Erhannis/VoltageBoard/voltage_tests.kicad_pcb

## KiCad design voltage_tests.kicad_pcb (2023-08-18)

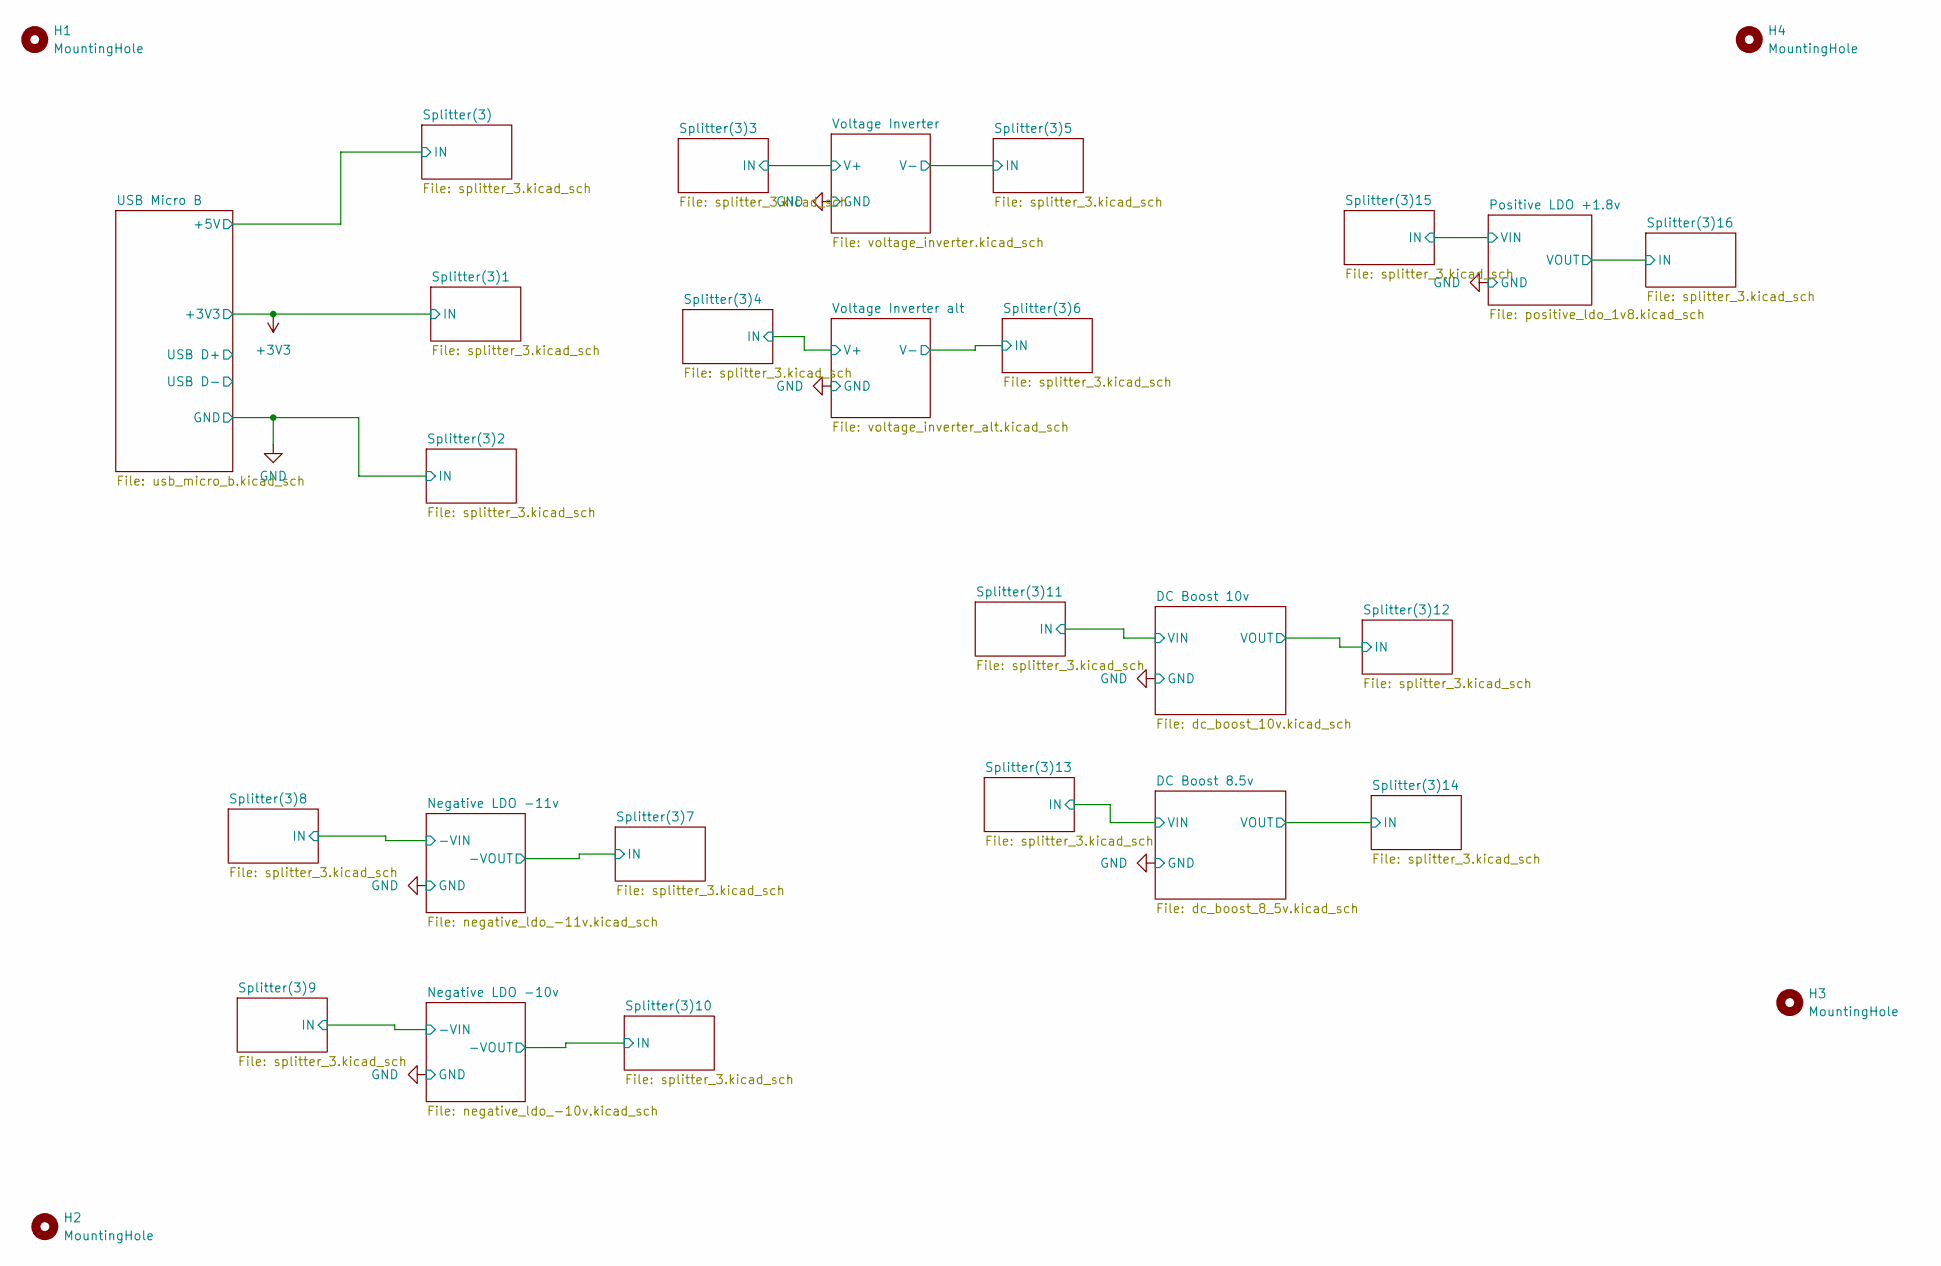
[picture p1: schematic voltage_tests.kicad_sch]

Parts:
H1, H2, H3, H4: MountingHole; MountingHole_2.5mm

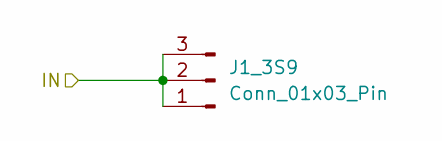
[picture p2: schematic splitter_3.kicad_sch]

Parts:
J1_3S9: Conn_01x03_Pin; PinHeader_1x03_P2.54mm_Vertical; LCSC C2937625

Connections:
/Negative LDO -11v/-VIN: J1_3S9.1, J1_3S9.2, J1_3S9.3; also elsewhere on the board

Parts of its further copies:
J1_3S1, J1_3S2, J1_3S3, J1_3S4, J1_3S5, J1_3S6, J1_3S7, J1_3S8, J1_3S10, J1_3S11, J1_3S12, J1_3S13, J1_3S14, J1_3S15, J1_3S16, J1_3S17: Conn_01x03_Pin; PinHeader_1x03_P2.54mm_Vertical; LCSC C2937625

Connections of its further copies:
+3V3: J1_3S2.1, J1_3S2.2, J1_3S2.3; also elsewhere on the board
/DC Boost 8.5v/VIN: J1_3S15.1, J1_3S15.2, J1_3S15.3; also elsewhere on the board
/DC Boost 8.5v/VOUT: J1_3S14.1, J1_3S14.2, J1_3S14.3; also elsewhere on the board
/DC Boost 10v/VIN: J1_3S13.1, J1_3S13.2, J1_3S13.3; also elsewhere on the board
/DC Boost 10v/VOUT: J1_3S12.1, J1_3S12.2, J1_3S12.3; also elsewhere on the board
/Negative LDO -10v/-VIN: J1_3S11.1, J1_3S11.2, J1_3S11.3; also elsewhere on the board
/Negative LDO -10v/-VOUT: J1_3S10.1, J1_3S10.2, J1_3S10.3; also elsewhere on the board
/Negative LDO -11v/-VOUT: J1_3S8.1, J1_3S8.2, J1_3S8.3; also elsewhere on the board
/Positive LDO +1.8v/VIN: J1_3S16.1, J1_3S16.2, J1_3S16.3; also elsewhere on the board
/Positive LDO +1.8v/VOUT: J1_3S17.1, J1_3S17.2, J1_3S17.3; also elsewhere on the board
/Splitter(3)3/IN: J1_3S4.1, J1_3S4.2, J1_3S4.3; also elsewhere on the board
/Splitter(3)4/IN: J1_3S5.1, J1_3S5.2, J1_3S5.3; also elsewhere on the board
/Splitter(3)5/IN: J1_3S6.1, J1_3S6.2, J1_3S6.3; also elsewhere on the board
/Splitter(3)6/IN: J1_3S7.1, J1_3S7.2, J1_3S7.3; also elsewhere on the board
/Splitter(3)/IN: J1_3S1.1, J1_3S1.2, J1_3S1.3; also elsewhere on the board
GND: J1_3S3.1, J1_3S3.2, J1_3S3.3; also elsewhere on the board

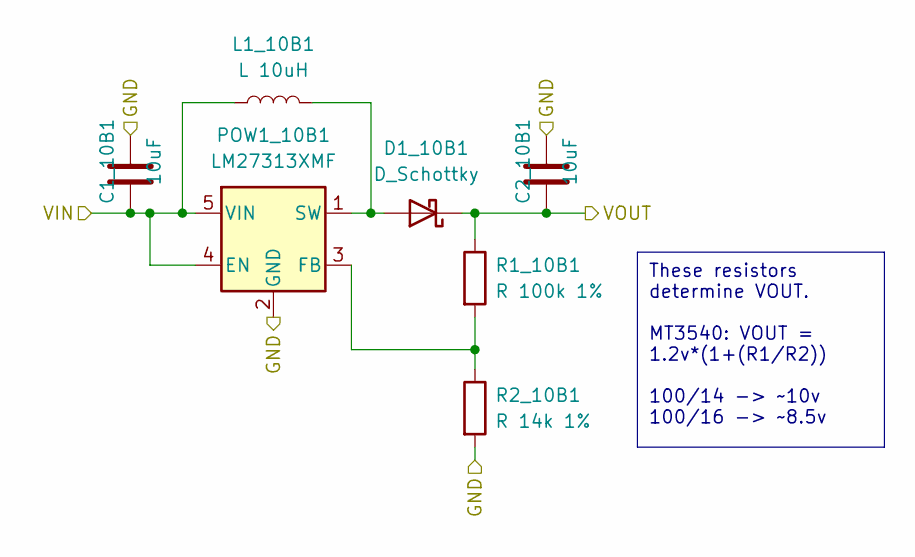
[picture p3: schematic dc_boost_10v.kicad_sch, DC/DC Boost Converter: 10V]

Parts:
C1_10B1, C2_10B1: 10uF; C_0603_1608Metric; LCSC C194427
D1_10B1: D_Schottky; D_0402_1005Metric; LCSC C2837790
L1_10B1: L 10uH; L_0805_2012Metric; LCSC C285963
POW1_10B1: LM27313XMF; SOT-23-5; LCSC C181744
R1_10B1: R 100k 1%; R_0402_1005Metric; LCSC C60491
R2_10B1: R 14k 1%; R_0402_1005Metric; LCSC C3015834

Connections:
/DC Boost 10v/VIN: C1_10B1.2, L1_10B1.1, POW1_10B1.4 (EN), POW1_10B1.5 (VIN); also elsewhere on the board
/DC Boost 10v/VOUT: C2_10B1.2, D1_10B1.1 (K), R1_10B1.1; also elsewhere on the board
GND: C1_10B1.1, C2_10B1.1, POW1_10B1.2 (GND), R2_10B1.2; also elsewhere on the board
unnamed: D1_10B1.2 (A), L1_10B1.2, POW1_10B1.1 (SW)
unnamed: POW1_10B1.3 (FB), R1_10B1.2, R2_10B1.1

Notes on the sheet:
These resistors determine VOUT. MT3540: VOUT = 1.2v*(1+(R1/R2)) 100/14 -> ~10v 100/16 -> ~8.5v

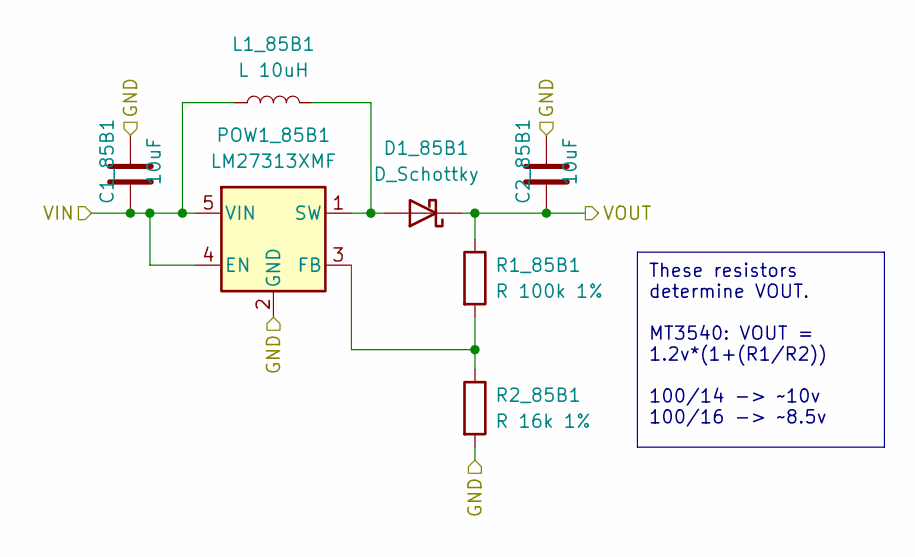
[picture p4: schematic dc_boost_8_5v.kicad_sch, DC/DC Boost Converter: 8.5V]

Parts:
C1_85B1, C2_85B1: 10uF; C_0603_1608Metric; LCSC C194427
D1_85B1: D_Schottky; D_0402_1005Metric; LCSC C2837790
L1_85B1: L 10uH; L_0805_2012Metric; LCSC C285963
POW1_85B1: LM27313XMF; SOT-23-5; LCSC C181744
R1_85B1: R 100k 1%; R_0402_1005Metric; LCSC C60491
R2_85B1: R 16k 1%; R_0402_1005Metric; LCSC C163487

Connections:
/DC Boost 8.5v/VIN: C1_85B1.2, L1_85B1.1, POW1_85B1.4 (EN), POW1_85B1.5 (VIN); also elsewhere on the board
/DC Boost 8.5v/VOUT: C2_85B1.2, D1_85B1.1 (K), R1_85B1.1; also elsewhere on the board
GND: C1_85B1.1, C2_85B1.1, POW1_85B1.2 (GND), R2_85B1.2; also elsewhere on the board
unnamed: D1_85B1.2 (A), L1_85B1.2, POW1_85B1.1 (SW)
unnamed: POW1_85B1.3 (FB), R1_85B1.2, R2_85B1.1

Notes on the sheet:
These resistors determine VOUT. MT3540: VOUT = 1.2v*(1+(R1/R2)) 100/14 -> ~10v 100/16 -> ~8.5v

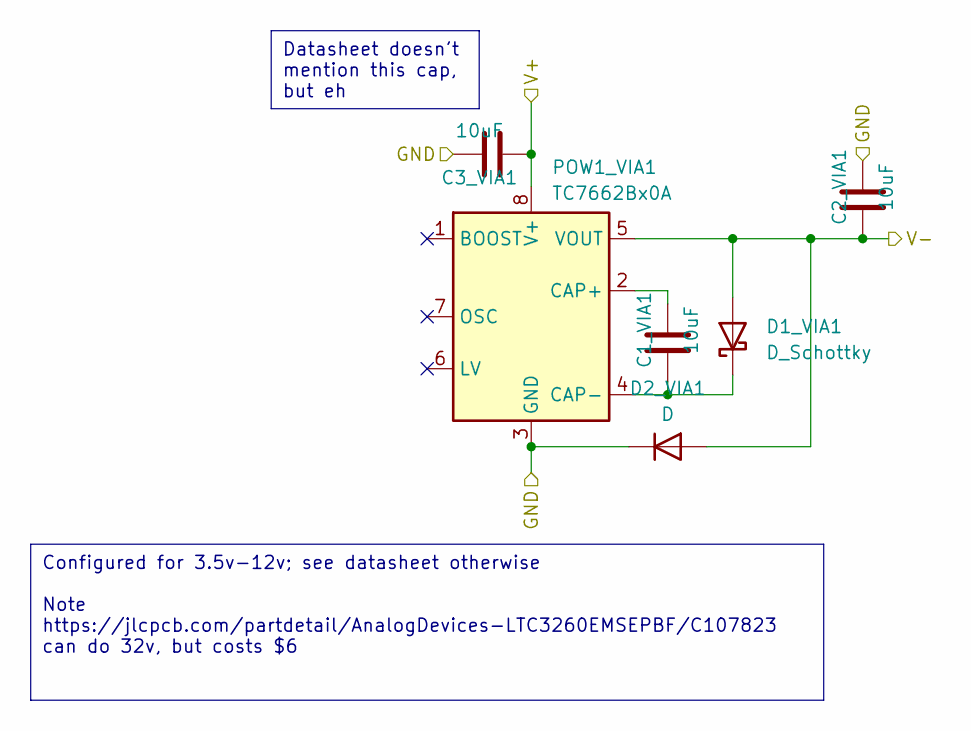
[picture p5: schematic voltage_inverter_alt.kicad_sch, Voltage Inverter 3.5v-12v]

Parts:
C1_VIA1, C2_VIA1, C3_VIA1: 10uF; C_0805_2012Metric; LCSC C1713
D1_VIA1: D_Schottky; D_0402_1005Metric; LCSC C2837790
D2_VIA1: D; D_0805_2012Metric; LCSC C109001
POW1_VIA1: TC7662Bx0A; SOIC-8_3.9x4.9mm_P1.27mm; LCSC C357815

Connections:
/Splitter(3)4/IN: C3_VIA1.2, POW1_VIA1.8 (V+); also elsewhere on the board
/Splitter(3)6/IN: C2_VIA1.2, D1_VIA1.2 (A), D2_VIA1.2 (A), POW1_VIA1.5 (VOUT); also elsewhere on the board
GND: C2_VIA1.1, C3_VIA1.1, D2_VIA1.1 (K), POW1_VIA1.3 (GND); also elsewhere on the board
unnamed: C1_VIA1.2, D1_VIA1.1 (K), POW1_VIA1.4 (CAP-)
unnamed: C1_VIA1.1, POW1_VIA1.2 (CAP+)

Notes on the sheet:
Configured for 3.5v-12v; see datasheet otherwise Note https://jlcpcb.com/partdetail/AnalogDevices-LTC3260EMSEPBF/C107823 can do 32v, but costs $6
Datasheet doesn't mention this cap, but eh

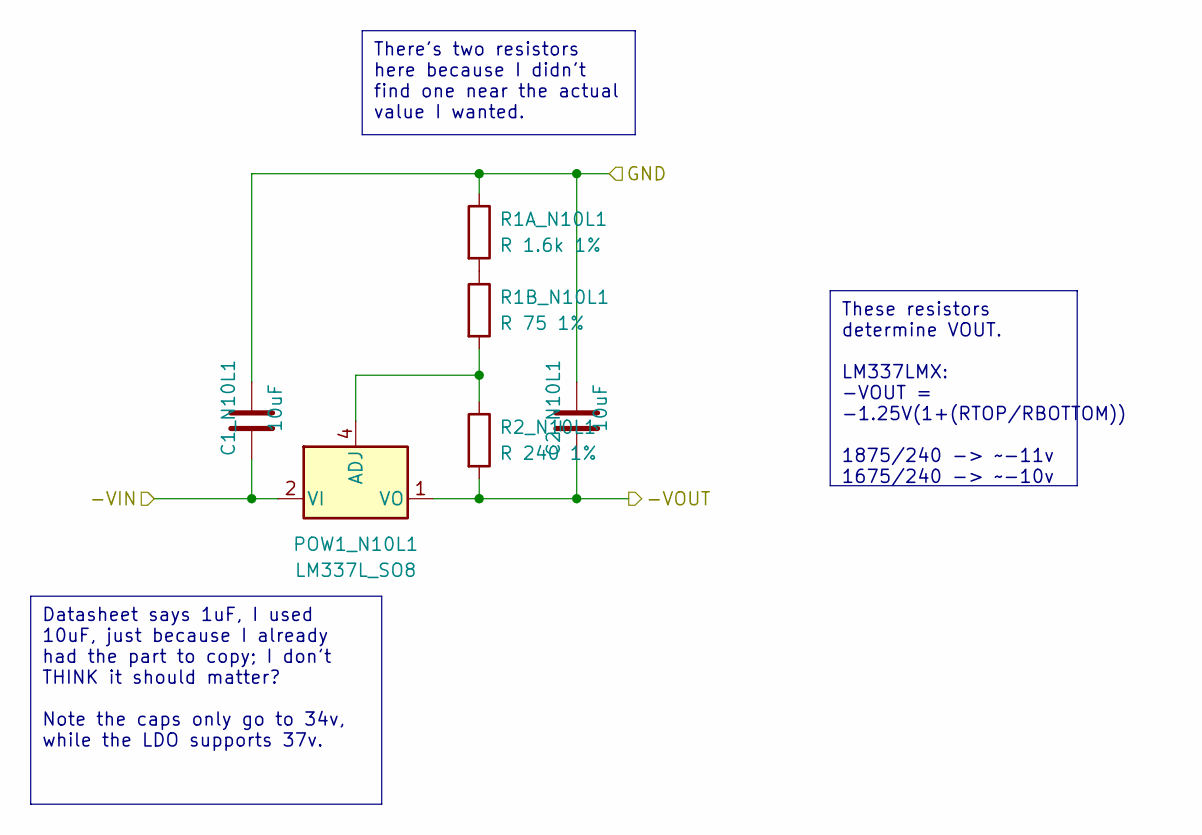
[picture p6: schematic negative_ldo_-10v.kicad_sch, Negative LDO: -10V]

Parts:
C1_N10L1, C2_N10L1: 10uF; C_0603_1608Metric; LCSC C194427
POW1_N10L1: LM337L_SO8; SOIC-8_3.9x4.9mm_P1.27mm; LCSC C544819
R1A_N10L1: R 1.6k 1%; R_0402_1005Metric; LCSC C4908
R1B_N10L1: R 75 1%; R_0402_1005Metric; LCSC C25133
R2_N10L1: R 240 1%; R_0402_1005Metric; LCSC C25094

Connections:
/Negative LDO -10v/-VIN: C1_N10L1.2, POW1_N10L1.2 (VI), POW1_N10L1.3 (VI), POW1_N10L1.6 (VI), POW1_N10L1.7 (VI); also elsewhere on the board
/Negative LDO -10v/-VOUT: C2_N10L1.2, POW1_N10L1.1 (VO), R2_N10L1.2; also elsewhere on the board
GND: C1_N10L1.1, C2_N10L1.1, R1A_N10L1.1; also elsewhere on the board
unnamed: POW1_N10L1.4 (ADJ), R1B_N10L1.2, R2_N10L1.1
unnamed: R1A_N10L1.2, R1B_N10L1.1

Notes on the sheet:
There's two resistors here because I didn't find one near the actual value I wanted.
Datasheet says 1uF, I used 10uF, just because I already had the part to copy; I don't THINK it should matter? Note the caps only go to 34v, while the LDO supports 37v.
These resistors determine VOUT. LM337LMX: -VOUT = -1.25V(1+(RTOP/RBOTTOM)) 1875/240 -> ~-11v 1675/240 -> ~-10v

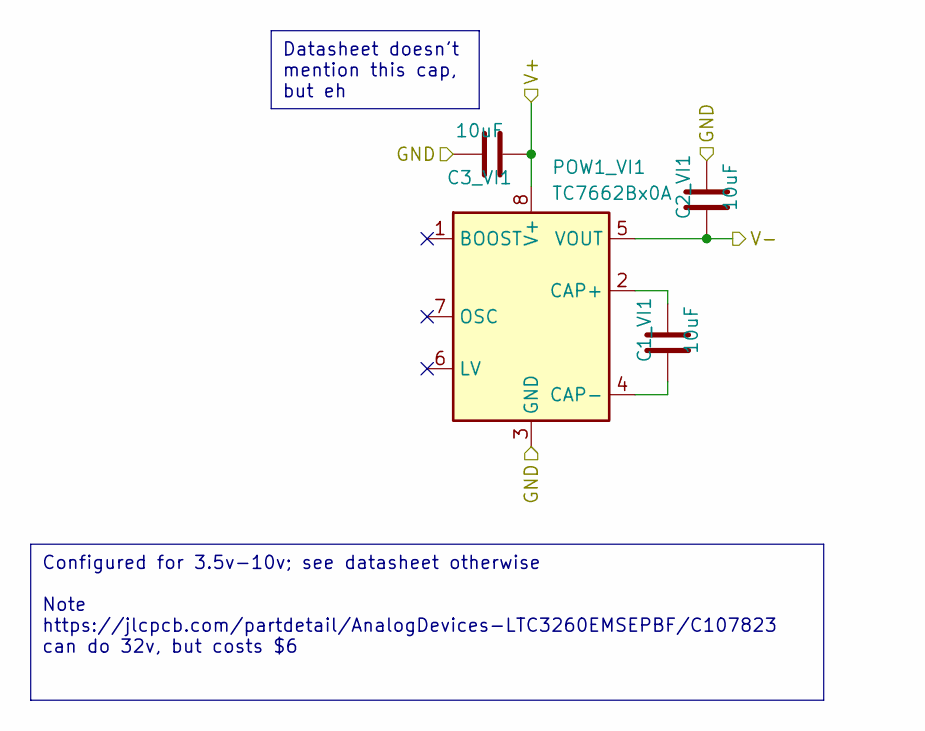
[picture p7: schematic voltage_inverter.kicad_sch, Voltage Inverter 3.5v-10v]

Parts:
C1_VI1, C2_VI1, C3_VI1: 10uF; C_0805_2012Metric; LCSC C1713
POW1_VI1: TC7662Bx0A; SOIC-8_3.9x4.9mm_P1.27mm; LCSC C88402

Connections:
/Splitter(3)3/IN: C3_VI1.2, POW1_VI1.8 (V+); also elsewhere on the board
/Splitter(3)5/IN: C2_VI1.2, POW1_VI1.5 (VOUT); also elsewhere on the board
GND: C2_VI1.1, C3_VI1.1, POW1_VI1.3 (GND); also elsewhere on the board
unnamed: C1_VI1.1, POW1_VI1.2 (CAP+)
unnamed: C1_VI1.2, POW1_VI1.4 (CAP-)

Notes on the sheet:
Configured for 3.5v-10v; see datasheet otherwise Note https://jlcpcb.com/partdetail/AnalogDevices-LTC3260EMSEPBF/C107823 can do 32v, but costs $6
Datasheet doesn't mention this cap, but eh

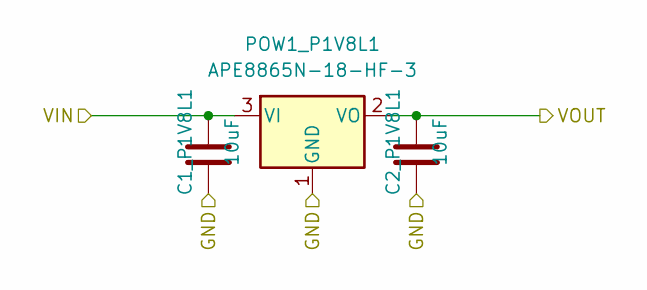
[picture p8: schematic positive_ldo_1v8.kicad_sch]

Parts:
C1_P1V8L1, C2_P1V8L1: 10uF; C_0603_1608Metric; LCSC C194427
POW1_P1V8L1: APE8865N-18-HF-3; SOT-23; LCSC C347373

Connections:
/Positive LDO +1.8v/VIN: C1_P1V8L1.1, POW1_P1V8L1.3 (VI); also elsewhere on the board
/Positive LDO +1.8v/VOUT: C2_P1V8L1.1, POW1_P1V8L1.2 (VO); also elsewhere on the board
GND: C1_P1V8L1.2, C2_P1V8L1.2, POW1_P1V8L1.1 (GND); also elsewhere on the board

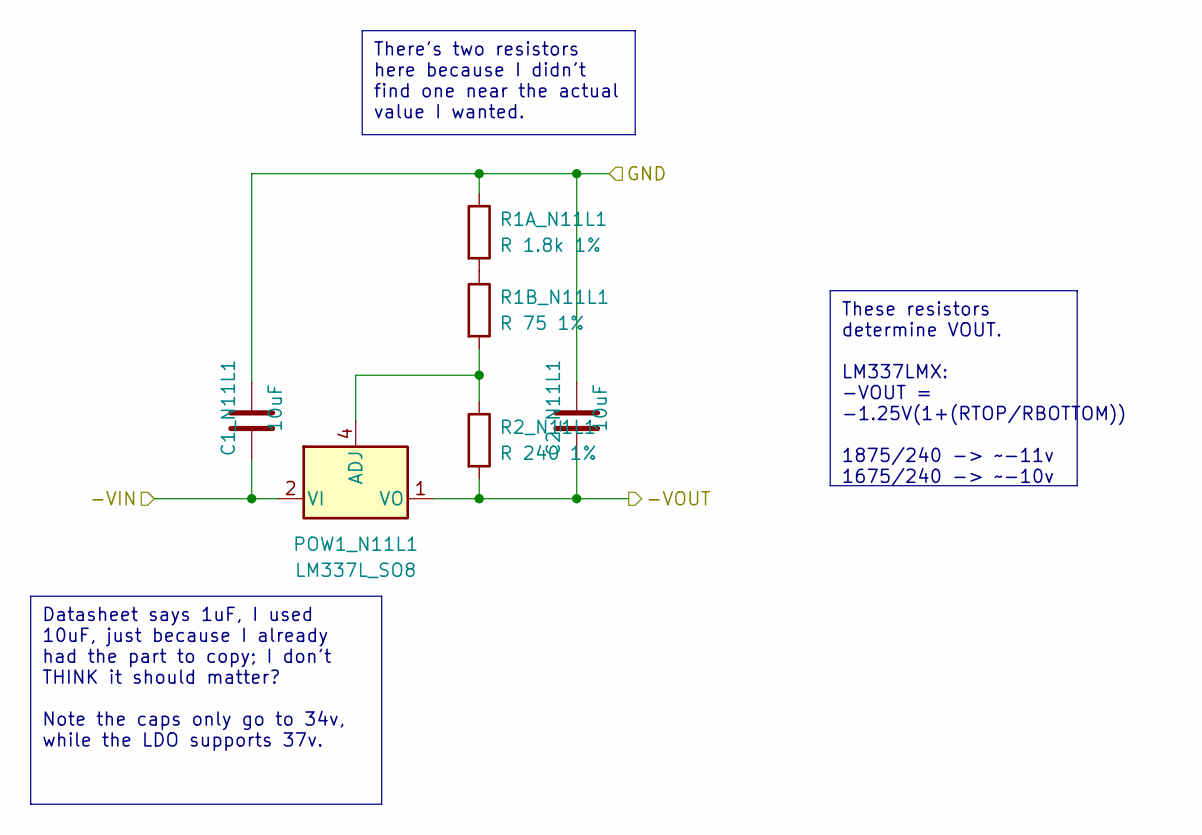
[picture p9: schematic negative_ldo_-11v.kicad_sch, Negative LDO: -11V]

Parts:
C1_N11L1, C2_N11L1: 10uF; C_0603_1608Metric; LCSC C194427
POW1_N11L1: LM337L_SO8; SOIC-8_3.9x4.9mm_P1.27mm; LCSC C544819
R1A_N11L1: R 1.8k 1%; R_0402_1005Metric; LCSC C2909310
R1B_N11L1: R 75 1%; R_0402_1005Metric; LCSC C25133
R2_N11L1: R 240 1%; R_0402_1005Metric; LCSC C25094

Connections:
/Negative LDO -11v/-VIN: C1_N11L1.2, POW1_N11L1.2 (VI), POW1_N11L1.3 (VI), POW1_N11L1.6 (VI), POW1_N11L1.7 (VI); also elsewhere on the board
/Negative LDO -11v/-VOUT: C2_N11L1.2, POW1_N11L1.1 (VO), R2_N11L1.2; also elsewhere on the board
GND: C1_N11L1.1, C2_N11L1.1, R1A_N11L1.1; also elsewhere on the board
unnamed: POW1_N11L1.4 (ADJ), R1B_N11L1.2, R2_N11L1.1
unnamed: R1A_N11L1.2, R1B_N11L1.1

Notes on the sheet:
There's two resistors here because I didn't find one near the actual value I wanted.
Datasheet says 1uF, I used 10uF, just because I already had the part to copy; I don't THINK it should matter? Note the caps only go to 34v, while the LDO supports 37v.
These resistors determine VOUT. LM337LMX: -VOUT = -1.25V(1+(RTOP/RBOTTOM)) 1875/240 -> ~-11v 1675/240 -> ~-10v

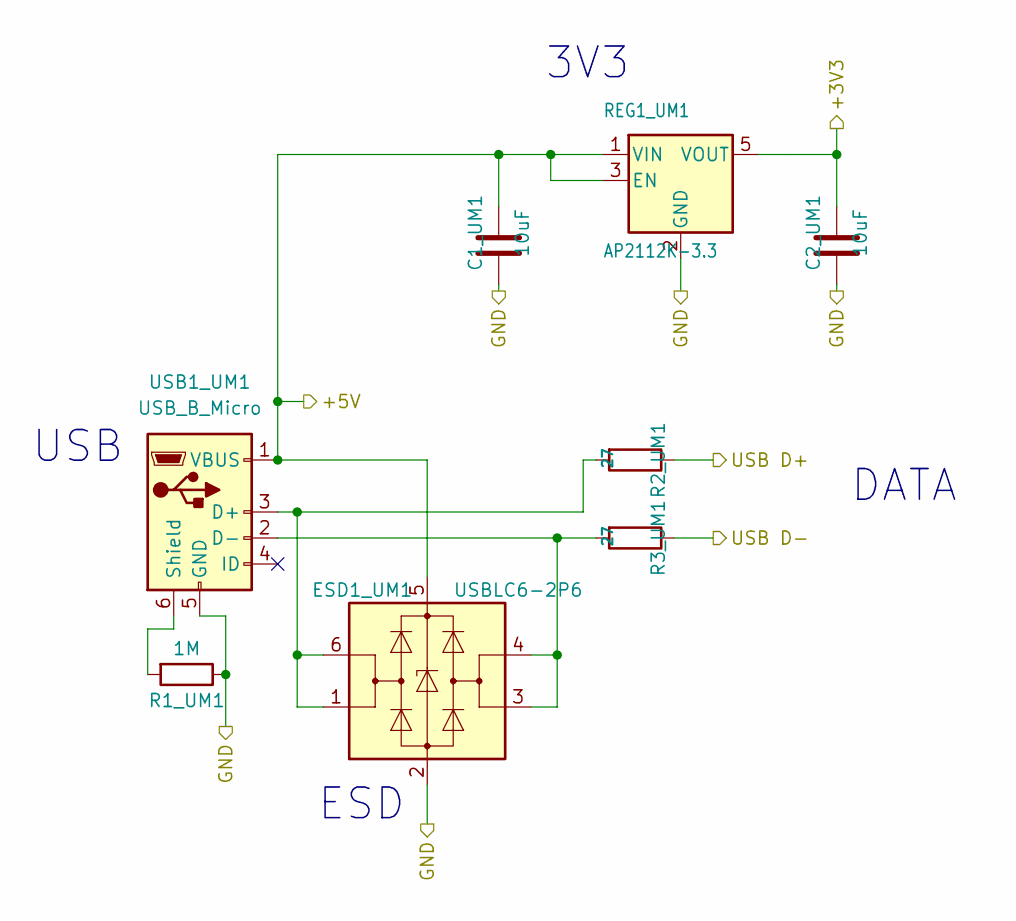
[picture p10: schematic usb_micro_b.kicad_sch, USB Micro B and 3V3 Power]

Parts:
C1_UM1, C2_UM1: 10uF; C_0805_2012Metric; LCSC C1713
ESD1_UM1: USBLC6-2P6; SOT-666; LCSC C2827693
R1_UM1: 1M; R_0402_1005Metric; LCSC C2906900
R2_UM1, R3_UM1: 27; R_0402_1005Metric; LCSC C25100
REG1_UM1: AP2112K-3.3; SOT-23-5; LCSC C51118
USB1_UM1: USB_B_Micro; USB_Micro-B_XKB_U254-051T-4BH83-F1S; LCSC C319160

Connections:
+3V3: C2_UM1.1, REG1_UM1.5 (VOUT); also elsewhere on the board
/Splitter(3)/IN: C1_UM1.1, ESD1_UM1.5 (VBUS), REG1_UM1.1 (VIN), REG1_UM1.3 (EN), USB1_UM1.1 (VBUS); also elsewhere on the board
/USB Micro B/USB D+: R2_UM1.1
/USB Micro B/USB D-: R3_UM1.1
GND: C1_UM1.2, C2_UM1.2, ESD1_UM1.2 (GND), R1_UM1.1, REG1_UM1.2 (GND), USB1_UM1.5 (GND); also elsewhere on the board
unnamed: ESD1_UM1.1 (I/O1), ESD1_UM1.6 (I/O1), R2_UM1.2, USB1_UM1.3 (D+)
unnamed: ESD1_UM1.3 (I/O2), ESD1_UM1.4 (I/O2), R3_UM1.2, USB1_UM1.2 (D-)
unnamed: R1_UM1.2, USB1_UM1.6 (Shield)

Notes on the sheet:
3V3
ESD
USB
DATA

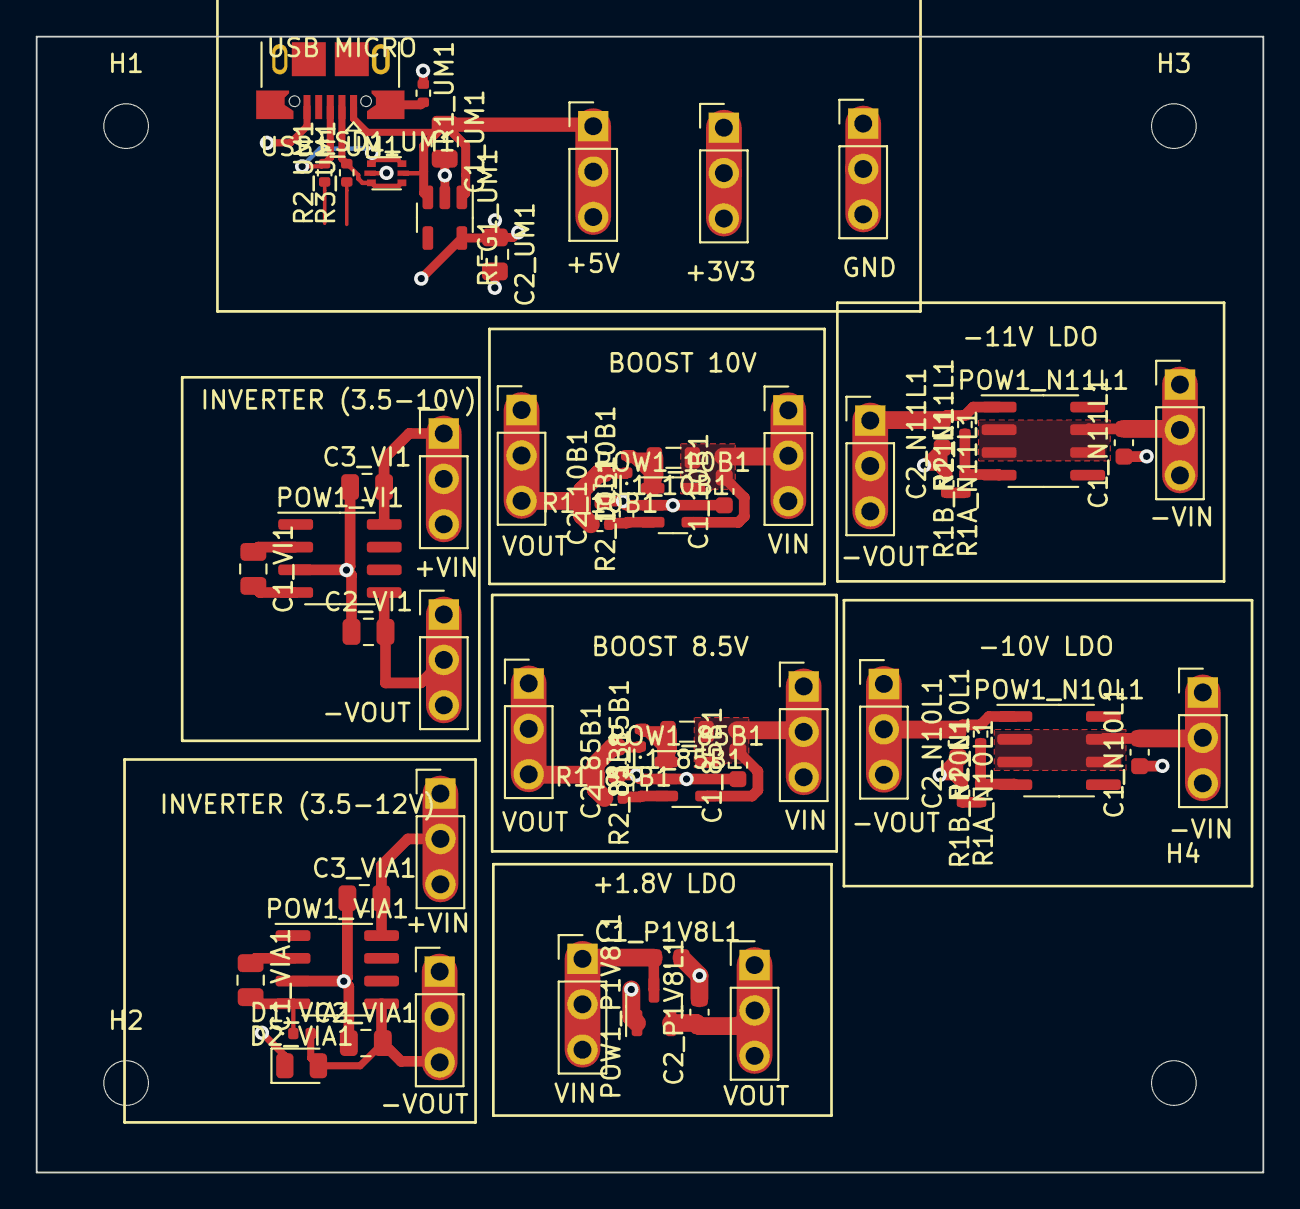
[picture p11: board voltage_tests.kicad_pcb from above]

Board: 4 copper layers, 68.6 x 63.5 mm, 68 parts (0 on the bottom side), 32 nets.
