Erhannis/VoltageBoard/(commit log)

2023-08-18 Ok! After a long buildup, I think we're off to the races!
    [dc_boost_10v.kicad_sch, dc_boost_8_5v.kicad_sch, negative_ldo_-10v.kicad_sch, negative_ldo_-11v.kicad_sch, splitter_3.kicad_sch, usb_micro_b.kicad_sch, voltage_inverter.kicad_sch, voltage_inverter_alt.kicad_sch]
2023-08-18 Ok, I've added all the power chips and splitters; that MAY be it
    [dc_boost_10v.kicad_sch, dc_boost_8_5v.kicad_sch, negative_ldo_-10v.kicad_sch, negative_ldo_-11v.kicad_sch, splitter_3.kicad_sch, voltage_inverter.kicad_sch, voltage_inverter_alt.kicad_sch, voltage_tests.kicad_pcb]
2023-08-18 Ok, maybe that's everything?
    [negative_ldo_-10v.kicad_sch, negative_ldo_-11v.kicad_sch, splitter_3.kicad_sch, voltage_tests.kicad_pcb, voltage_tests.kicad_sch]
2023-08-18 Ok, added an 1v8 LDO *sigh*
    [positive_ldo_1v8.kicad_sch, splitter_3.kicad_sch, voltage_tests.kicad_pcb, voltage_tests.kicad_sch]
2023-08-18 AND the labels
    [voltage_tests.kicad_pcb]
2023-08-18 Hash, and gerbers
    [bom.csv, designators.csv, positions.csv, voltage_tests.kicad_pcb]
2023-08-18 Eh, moved repo
    [voltage_tests.kicad_pcb]
