Erhannis/VoltageBoard/(notices)

Notices in the files:
usb_micro_b.kicad_sch:
From https://github.com/gregdavill/advent-calendar-of-circuits-2020 (CERN-OHL-P-2.0)
